jwilts/MegaCubCarTimer/RedBackground.JPG

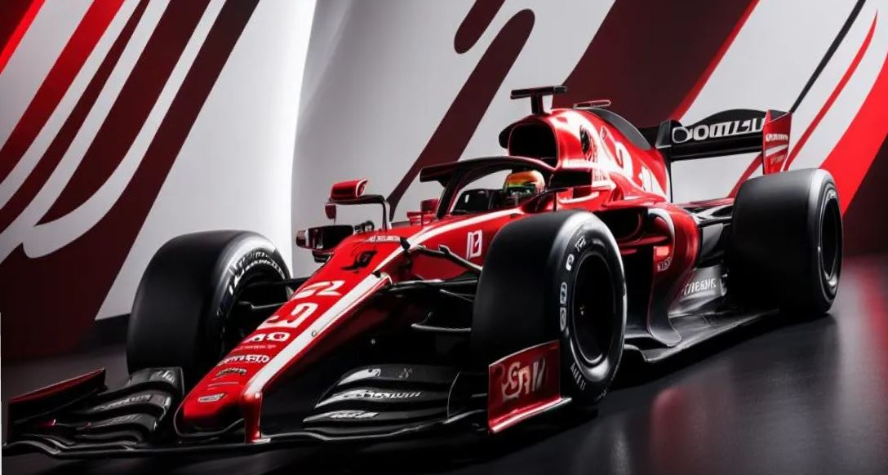
RedBackground.JPG
