jwilts/MegaCubCarTimer/Notes.txt

Red Faced Timer works with Beamsville new wood track
No issues with code or configuration
