jwilts/MegaCubCarTimer/Documentation/BitsAndPieces.pptx

Race Management
Station

Race Management
Station

Race Management
Station

Race Management
Station

Timer 1

Timer 1

Timer 1

Registration Station 1

Registration Station 1

Registration Station 1

Raspberry Pi
RC522
Can Use Timer OR
A dedicated station
Can run multiple registration stations

Microsoft Access
(Optional)
Can run multiple

Timer 1

Timer 1

Raspberry Pi
RC522
LDR’s
LED’s
Switches etc.
Can run multiple timers

Maria DB
Database

Can run on Pi
OR
Can run on Laptop
