jwilts/MegaCubCarTimer/CubCar-1.png

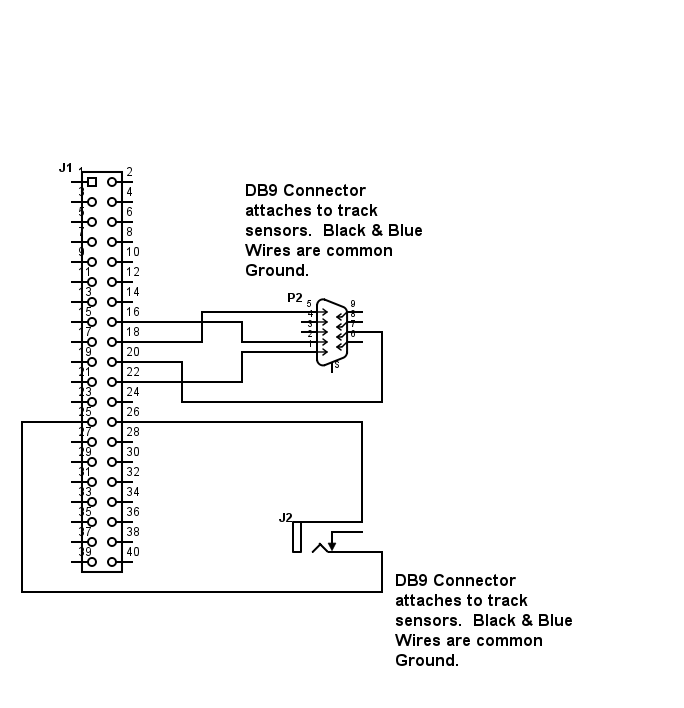
CubCar-1.png
