jwilts/MegaCubCarTimer/Timer/PI/RMsettings.ini

[Settings]
GPIO_relay_1 = 37
GPIO_track_switch = 29
track_switch_bounce_time = 600
GPIO_car_select_switch = 32 
car_select_bounce_time = 600
switch3_bounce_time = 600
max_race_time = 12
min_race_time = 1
GPIO_ldr_lane_1 = 38
GPIO_ldr_lane_2 = 40
GPIO_ldr_lane_3 = 36
leds = 3,5,7,11,13,15,8,10,12
unit = 6
matrix_yn = N
relay_yn = N
LCD_yn = N
LCD_Address = 0x27

[dbase]
use_database_yn = Y
host=192.168.0.33
user=cubcaradmin
passwd=cubsrock
database=CubCar

[Races]
gfastestlane = 2
gfastesttime = 2.8618221283
gfastestracecounter = 6
race_counter = 0
heat = 2
