jwilts/MegaCubCarTimer/Timer/PI/NewRead.py

#!/usr/bin/env python3
# -*- coding: utf8 -*-
#


import MFRC522
import signal

continue_reading = True


# function to read uid and convert it to a decimal string
def uidToString(uid):
    return ''.join([str(i) for i in uid])


# Capture SIGINT for cleanup when the script is aborted
def end_read(signal, frame):
    global continue_reading
    print("Ctrl+C captured, ending read.")
    continue_reading = False

# Hook the SIGINT
signal.signal(signal.SIGINT, end_read)

# Create an object of the class MFRC522
MIFAREReader = MFRC522.MFRC522()

# Welcome message
print("Welcome to the MFRC522 data read example")
print("Press Ctrl-C to stop.")

# This loop keeps checking for chips.
# If one is near it will get the UID and authenticate
while continue_reading:

    # Scan for cards
    (status, TagType) = MIFAREReader.MFRC522_Request(MIFAREReader.PICC_REQIDL)

    # If a card is found
    if status == MIFAREReader.MI_OK:
        print ("Card detected")

        # Get the UID of the card
        (status, uid) = MIFAREReader.MFRC522_SelectTagSN()
        # If we have the UID, continue
        if status == MIFAREReader.MI_OK:
            print("Card read UID: %s" % uidToString(uid))
        else:
            print("Authentication error")
