jwilts/MegaCubCarTimer/(commit log)

2024-09-23 Add files via upload
    Files are a chaotic mess and need to be organized. Dropping here so that I dont lose them.
    [2024 MotherBoard Docs.xlsx, GPIO 2025 CubCar.xlsx]
2024-09-26 Reorganize Documents
    [2024 MotherBoard Docs.xlsx, GPIO 2025 CubCar.xlsx]
2024-10-15 Add WebRegister Initial upload from server. (Includes Sample Data and images)
